nguyenkduy28/Eye-Gaze-Detection-System-using-EOG-Signals-Inprocess-/README.md

# Eye-Gaze-Detection-System-using-EOG-Signals-Inprocess-
Designed and implemented an EOG signal processing circuit using AgCl electrodes, including amplification, filtering, summation, and subtraction circuits.
