nguyenkduy28/Eye-Gaze-Detection-System-using-EOG-Signals-Inprocess-/(list of files, drawings)

Other design files:
PCB_Project_EOG_git/EOG_FRONT_END.SchDoc
PCB_Project_EOG_git/PCB2.PcbDoc
PCB_Project_EOG_git/PCB_Project_EOG.PrjPcb
PCB_Project_EOG_git/Power supply.SchDoc
PCB_Project_EOG_git/Power tree.SchDoc
